ianm8/uDCR/P1.jpg

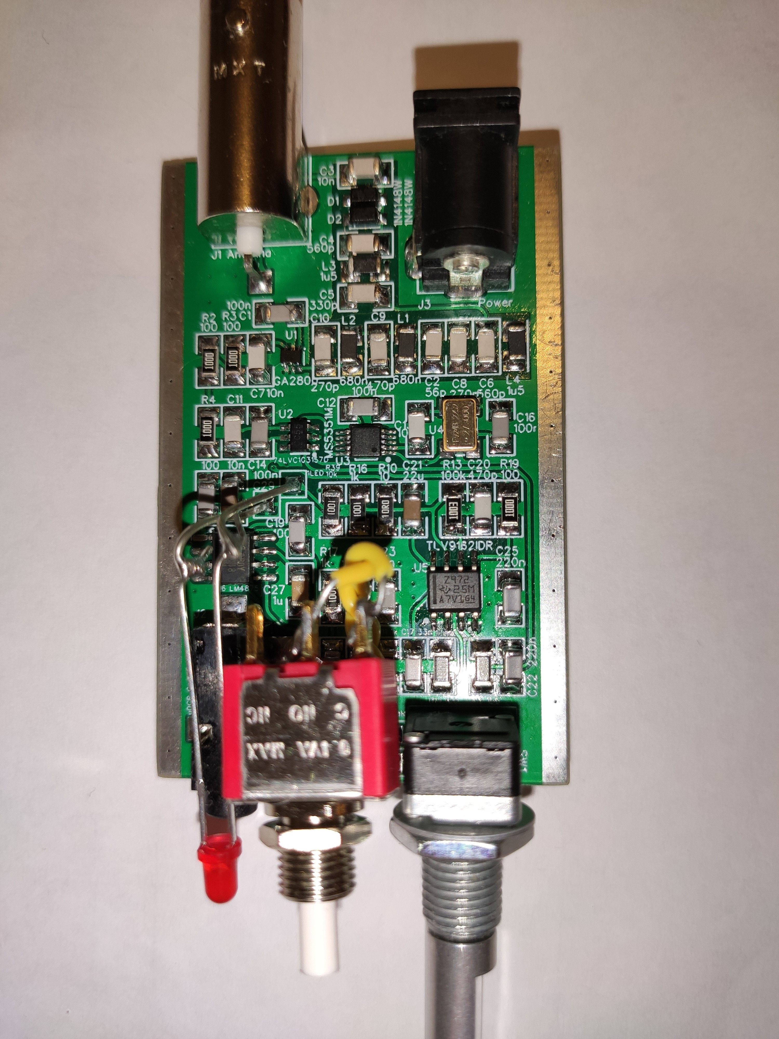
P1.jpg
