ianm8/uDCR/P2.jpg

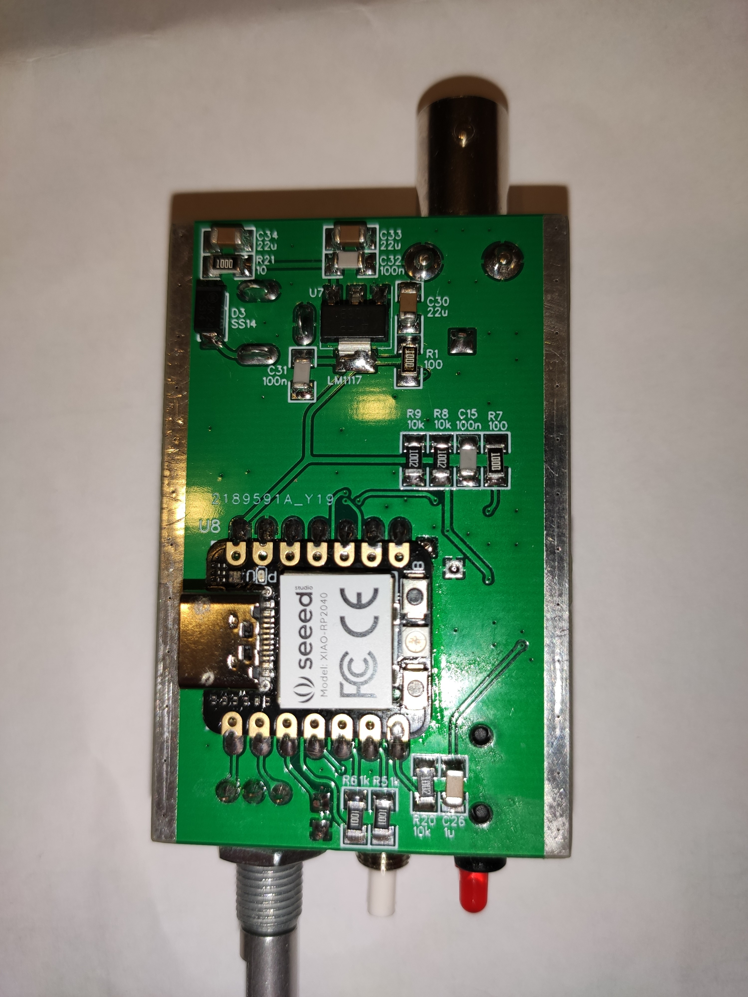
P2.jpg
