ianm8/uDCR/Schematic_uDCR_2023-05-31.pdf

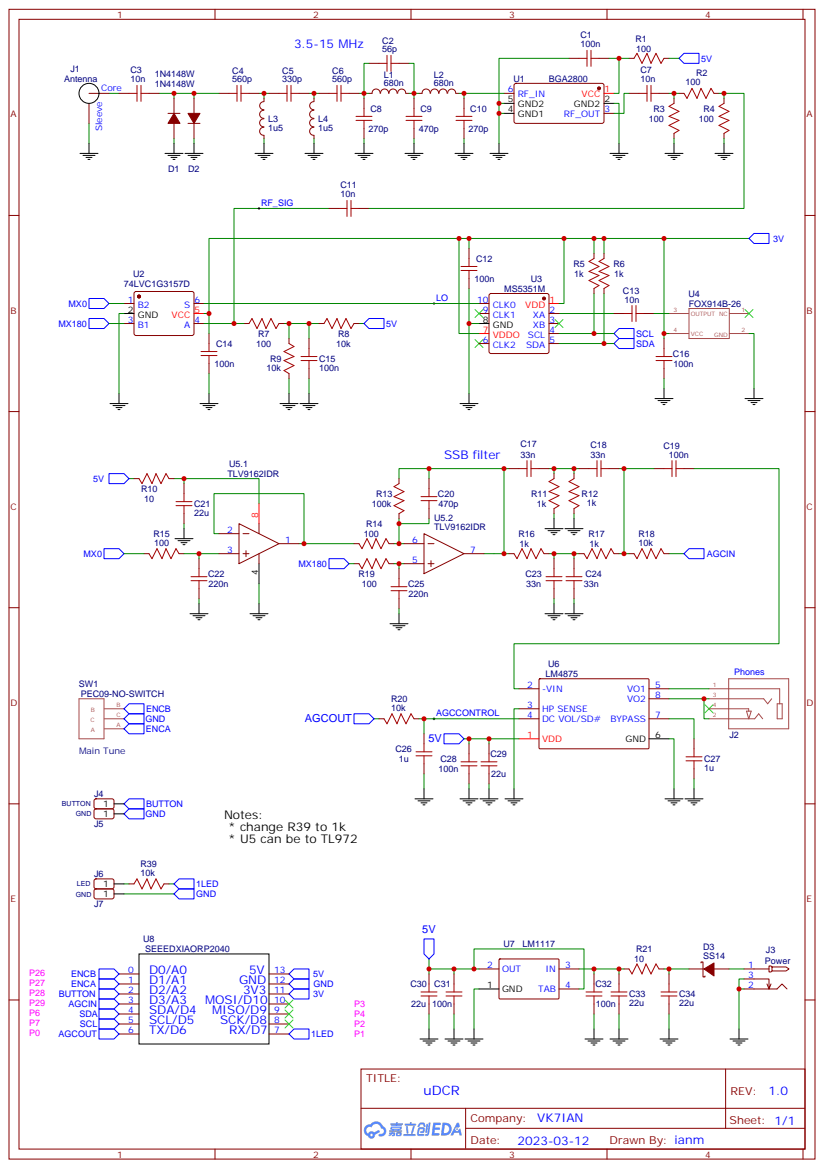
[picture p3: page 1]
