ianm8/uDCR/PCB/PCB_uDCR_BOTTOM.pdf

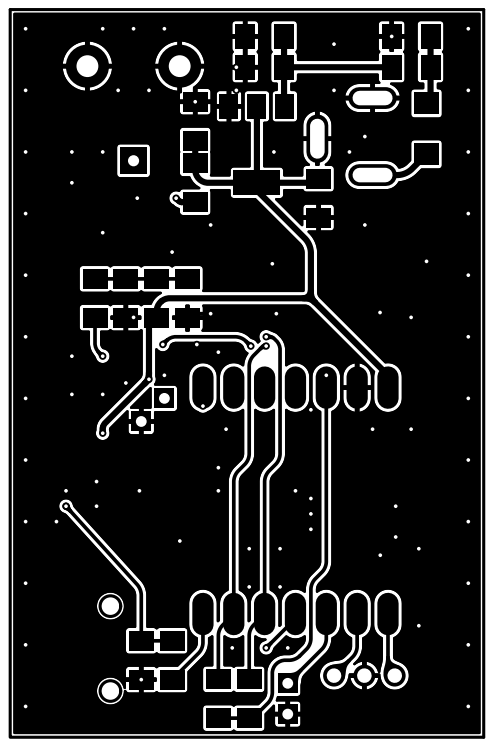
[picture p4: page 1]
