ianm8/uDCR/PCB/PCB_uDCR_BOTTOM_SILK.pdf

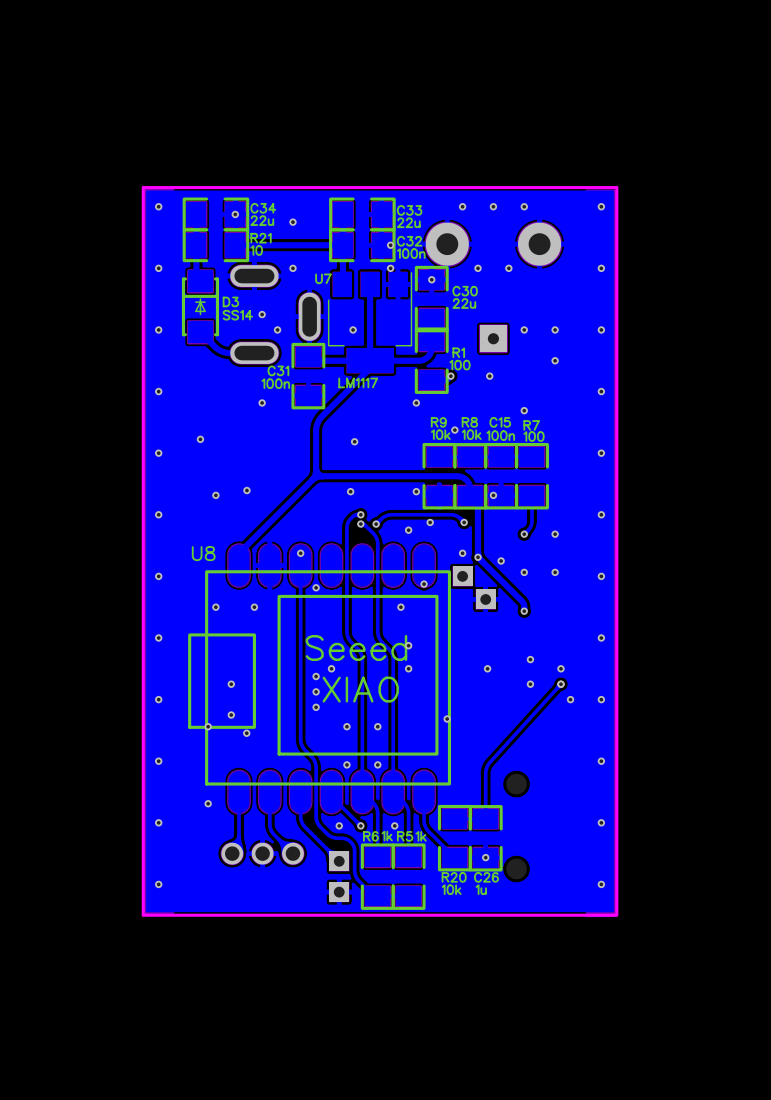
[picture p5: page 1]
