ianm8/uDCR/PCB/PCB_uDCR_TOP.pdf

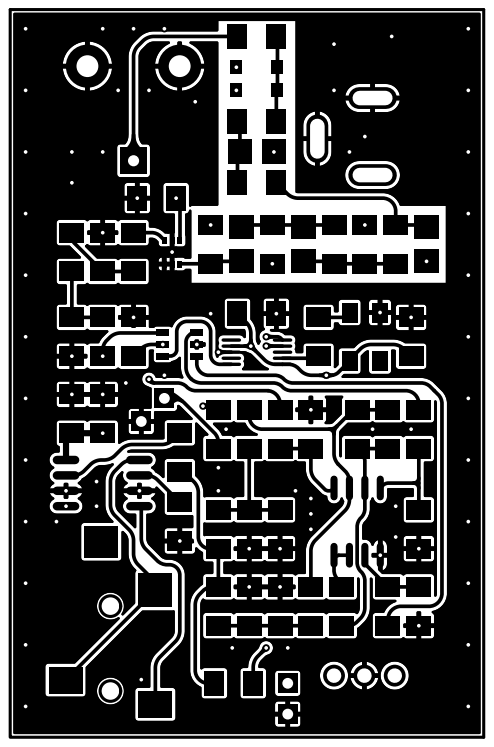
[picture p6: page 1]
