ianm8/uDCR/PCB/PCB_uDCR_TOP_SILK.pdf

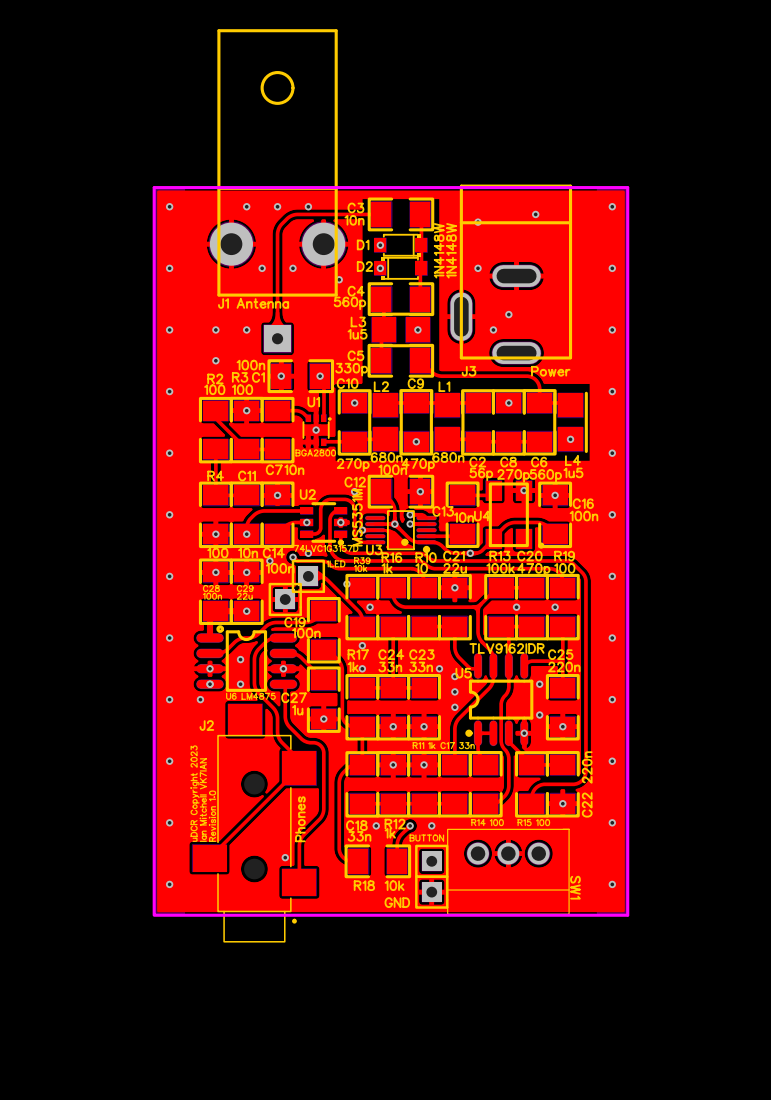
[picture p7: page 1]
