ianm8/uDCR/src/agc.h

#ifndef AGC_H
#define AGC_H

#define MIN_AGC 110u
#define MAX_AGC 255u

namespace AGC
{
  static const uint8_t agc_tab[2048] =
  {
    0u,
    0u,
    0u,
    0u,
    0u,
    0u,
    0u,
    0u,
    0u,
    0u,
    0u,
    0u,
    0u,
    0u,
    0u,
    0u,
    0u,
    0u,
    0u,
    0u,
    0u,
    0u,
    0u,
    0u,
    0u,
    0u,
    0u,
    0u,
    0u,
    0u,
    0u,
    0u,
    0u,
    0u,
    0u,
    0u,
    0u,
    0u,
    0u,
    0u,
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
  };

  static const int16_t dc(const int16_t in)
  {
    static int32_t s = 0;
    static int32_t x1 = 0;
    static int16_t y1 = 0;
    s -= x1;
    x1 = (int32_t)in << 16;
    s += x1 - ((int32_t)y1 << 8);
    return (y1 = s >> 16);
  }

  static const uint32_t peak(const int16_t sig)
  {
    volatile static uint32_t p = 0;
    const int32_t agc_dc = (int32_t)dc(sig);
    const uint32_t level = ((uint32_t)abs(agc_dc))<<9;
    if (level>p)
    {
      p = level;
    }
    else
    {
      if (p) p--;
    }
    return p>>9;
  }

  static const uint8_t attenuation(const uint32_t peak)
  {
    // given the signal peak value,
    // return the appropriate attenuation to
    // be subtracted from the volume PWM level
    // watch out for the abs(-2048) edge case!
    return agc_tab[min(peak,2047u)];
  }
}
#endif
