ianm8/uDCR/(commit log)

2023-05-30 Update uDCR10.ino
    Added header and textual fixes - no code changes.
    [uDCR10.ino]
2023-05-31 PCB
    Photos of PCB - top and bottom view.
2023-05-31 uDCR Schematic
2023-06-02 PCB View
